cdun954/P4P-Buoy/README.md

# P4P-Buoy
University of Auckland
Department of ECSE

Project 108: Mobile Autonomous Buoy
