cdun954/P4P-Buoy/Hardware/Altium/Peripheral_PCB.PcbDoc.htm

Reporting Options

# File in Newer Format

Date | : | 12/09/2025
Time | : | 9:41:13 AM
Filename | : | Z:\Documents\GitHub\P4P-Buoy\Hardware\Altium\Peripheral_PCB.PcbDoc

Version | Warning
Release 23.6 | CAUTION - The PCB document contains Footprint parameters. These will be lost when opening the document in a version of Altium Designer that does not support this functionality.

This file was generated by a later version of the software
