cdun954/P4P-Buoy/Hardware/Altium/Peripheral_Board.html

Reporting Options

# File in Newer Format

Date | : | 9/09/2025
Time | : | 7:46:28 PM
Project name | : | Z:\Documents\GitHub\P4P-Buoy\Hardware\Altium\Peripheral_Board.PrjPcb
Schematic documents | : | P4P_PCB.SchDoc

Version | Warning
21.9.0 | Internal Pull Up/Down resistor in components are not supported in this version.
22.3.0 | Custom diff pair suffixes are not supported in this version.

These files were generated in a later version of Altium Designer. Be aware that some data may have been added through functionality not available in your current version and will therefore not be available to you.
