cdun954/P4P-Buoy/108_cdun954_cpil673-compendium/Mounting/MBB_Motor_Box_Bracket_Right_v1.stl

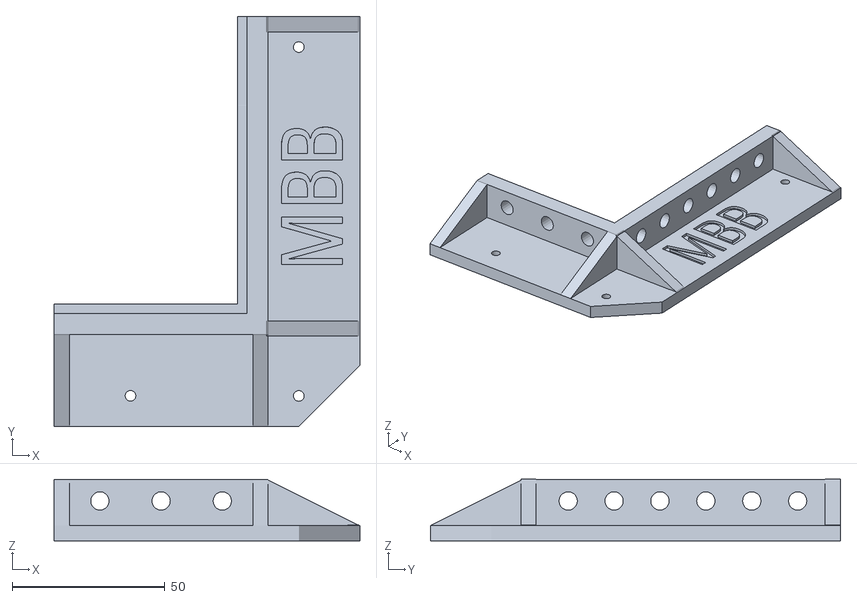
[picture p43: CAD file, 2025-10-20]
108_cdun954_cpil673-compendium/Mounting/MBB_Motor_Box_Bracket_Right_v1.stl
100.0 x 134.0 x 20.1
