cdun954/P4P-Buoy/108_cdun954_cpil673-compendium/Mounting/MBB_Box_Bracket_Front_v1.stl

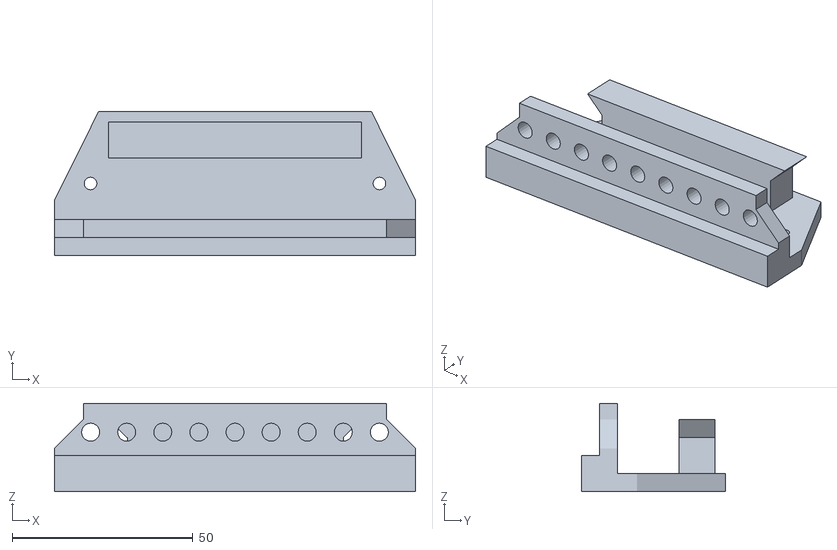
[picture p44: CAD file, 2025-10-20]
108_cdun954_cpil673-compendium/Mounting/MBB_Box_Bracket_Front_v1.stl
100.0 x 40.0 x 24.5
