cdun954/P4P-Buoy/(list of files, cad)

Other CAD files:
108_cdun954_cpil673-compendium/Mounting/MBB_Motor_Box_Bracket_Left_v2.stl
