cdun954/P4P-Buoy/108_cdun954_cpil673-compendium/setup.docx

Project 108

Compendium

Connor Dunn

Cromwell Pilacan

Supervisor: Dr Akshat Bisht

Co-supervisor: Dr Kevin I-Kai Wang

Department of Electrical, Computer and Software Engineering

The University of Auckland

October 2025

# 1 BOM

Table 1: Complete Testing BOM

Testing BOM
System | Component | Amount | Cost
Power | LiPo Batteries 5500mAh (https://hobbystation.co.nz/giant-power-4s-14-8v-5500mah-65c-graphene-hardcase-li-po-battery-w-xt60-plug/) | 2 | 358
| 5V Buck Converter (https://epartners.co.nz/products/hs1007?_pos=1&_sid=1f943ed0d&_ss=r) | 1 | 7.99
Mobility | Pixhawk6C + GPS + PM07 (https://holybro.com/products/pixhawk-6c) | 1 | 358
| T200 Motors (https://bluerobotics.com/store/thrusters/t100-t200-thrusters/t200-thruster-r2-rp/) | 2 | 800
| ESC (https://bluerobotics.com/store/thrusters/speed-controllers/besc30-r3/) | 2 | 140
Hull | Remote Controller + Receiver (https://www.aliexpress.com/item/1005005510830129.html?src=google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) | 2 | 28
| Mounting (https://bluerobotics.com/store/thrusters/t100-t200-thrusters/t100-p-bracket-r1/) | 1 | 229.93
| Boogie Board (https://www.thewarehouse.co.nz/p/body-glove-33-inches-divert-bodyboard/R2929906.html) | 1 | 35
| Water Sealant | 1 | Approximately 20
| Waterproof Box | 1 | Approximately 80
| Mounts | - | -
| Screws | 8 | -
Autonomy | Raspberry Pi 4B (https://pbtech.co.nz/product/SEVRBP0205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) | 1 | 26.08
| ESP 32 (https://www.digikey.co.nz/en/products/detail/espressif-systems/ESP32-DEVKITC-32UE/12091813?gclsrc=aw.ds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) | 1 | 17.38
| Modem (https://www.aliexpress.com/item/1005005735349781.html?src=google&gQT=2) | 1 | 75.41
| | Total Cost | 2215.79

# 2 Setup

All necessary code can be found within the zip file in their respectively named folders.

## 2.1 Flight Controller (FC)

1. Install Mission Planner (https://ardupilot.org/planner/docs/mission-planner-installation.html)
2. Connect FC via USB.
3. Flash Rover
  a. Setup → Install Firmware → Rover (OFFICIAL)
4. Connect
  a. Port: COMx (check Device Manager)
  b. Baud: 115200 → Connect
5. Load Parameters
  a. Config → Full Parameter List → Load from file → param.param → Write Params
6. Wire Peripherals
  a. PM07 Power1 → FC POWER1
  b. PM07 MAIN PWM OUT → FC I/O PWM OUT [MAIN]
  c. GPS → FC GPS1
  d. RC → FC PPM/SBUS RC
  e. Pi → FC USB
7. Calibrate
  a. Mandatory Hardware → Accelerometer (all orientations)
  b. Compass (away from interference; “Relaxed” only if needed)
  c. Radio Calibration (all channels)

## 2.2 GUI and Communication

Tailscale (https://login.tailscale.com/admin/machines)

1. Sign Up
2. Register Laptop and Pi to preset IP addresses

HiveMQ (https://console.hivemq.cloud/)

1. Sign Up
2. Create Cluster
3. Save credentials and MQTT url

Fix

1. Edit gui.py to update mqtt credentials and ips
2. Edit main.ino to update mqtt credentials and wi-fi
3. Edit main.py to update mqtt credentials

## 2.3 Raspberry Pi

1. Plug USB modem into USB
2. Flash Raspberry Pi (https://www.raspberrypi.com/software/) OS (Bookworm)
  a. Wi-Fi
  b. Set user
  c. SSH enabled
3. SSH into Pi (ssh pi@<taiscale ip>)
  a. Can check if connected via tailscale
4. Install Linux deps
  a. sudo apt update && sudo apt install -y python3-pip python3-venv tmux
5. Create Python env
  a. python3 -m venv ~/python && source ~/python/bin/activate
6. Install Python deps
  a. pip install pymavlink mavproxy paho-mqtt
7. Move project files via SSH
  a. > scp -r ./src/* pi@<ip>:/home/pi/Desktop/project
8. Move startup script and enable
  a. > scp -r ./project_boot.service pi@<ip>:/etc/systemd/system/
  b. sudo systemctl enable --now project_boot.service
  c. sudo reboot

## 2.4 ESP Power Controller

Although integration via PCB was incomplete, the ESP is setup to monitor power metrics and FSM based power switching through SSRs

1. Download IDE (https://www.arduino.cc/en/software)
  a. Flash main.ino to the ESP32

Done, just connect power, ground and things to these pins:

ADC_I_PI_PIN 36

ADC_I_FC_PIN 39

ADC_I_MODEM_PIN 34

ADC_I_ESP_PIN 35

ADC_V_BATT_PIN 32

PI_SHUTDOWN_PIN 4

RELAY_PI_PIN 23

RELAY_MODEM_PIN 22

RELAY_FC_PIN 21

## 2.5 Test Setup

Open GUI

Open Mission Planner

Power the Pi and modem

SSH into pi and run

- Tmux attach -t project

Click “MAVProxy” and it should just connect

Fake data should stream to the GUI as well.

# 3 GUI

Open gui.py

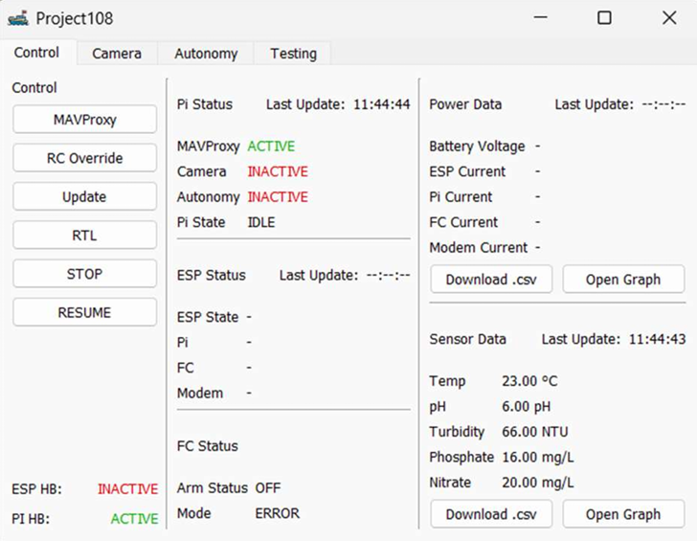
[picture p45: figure]

Control Tab

- MAVProxy : opens mavproxy through the pi
- RC Override : forces the FC into MANUAL mode
- Update : forces an update from the pi and esp
- RTL : forces the FC into RTL mode
- STOP : stops all autonomous processes and esp power control
- RESUME : resumes all autonomous processes and esp power control
- Download .csv : downloads all obtained session data
- Open Graph : Live graph of obtained session data

Camera Tab

- Toggle Camera : opens the Pi camera live feed

Autonomy Tab

- Toggle Autonomy : starts the autonomous process
- Params : alter the autonomy
- Autonomy visualiser not implemented

# 4 Lab Power Testing

The goal for lab testing was to get current readings for all peripherals intended for final design. Readings from the digital power supply was taken by visual inspection of the display over one minute, after giving enough time to boot for components running code.

### 4.1.1 Set Up

Figure below for each test ran, the components used and how they were connected. The input of the buck converter used lab available wires and alligator clips. Specific components used can be found in the testing bill of materials.

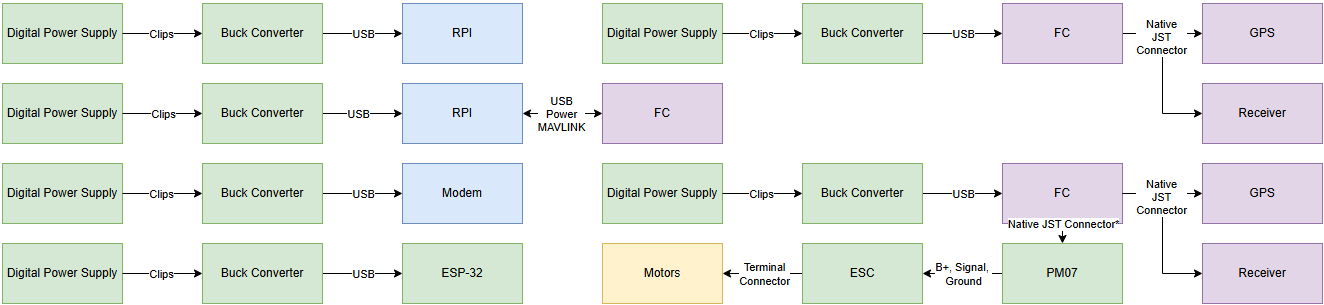
[picture p46: figure]

Figure 1.2.1: Lab Testing Connections

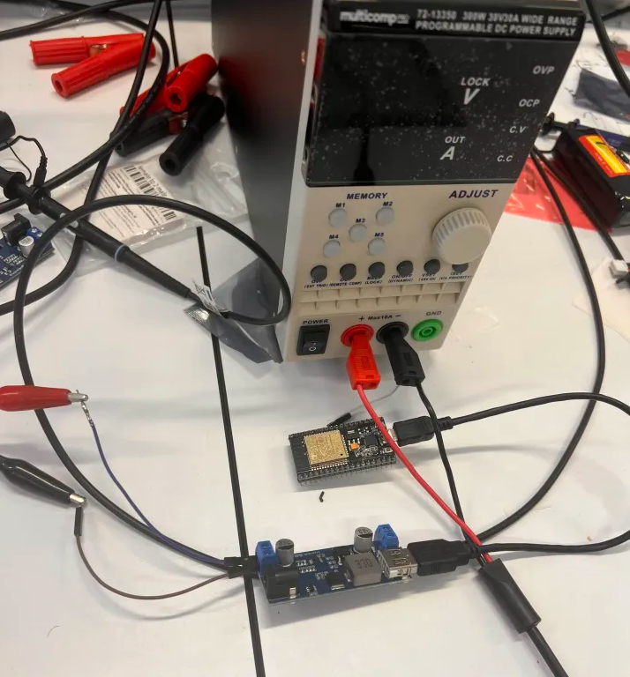
[picture p47: figure]

Figure 2.1: Photo Example of ESP Testing Set Up.

### 4.1.2 Code

The ESP ADC code and Raspberry Pi code has been included in their respective files.

### 4.1.3 Results

MAVPROXY refers to the Mavproxy process running on the Pi

ALGORITHM refers to the algorithm process running on the Pi

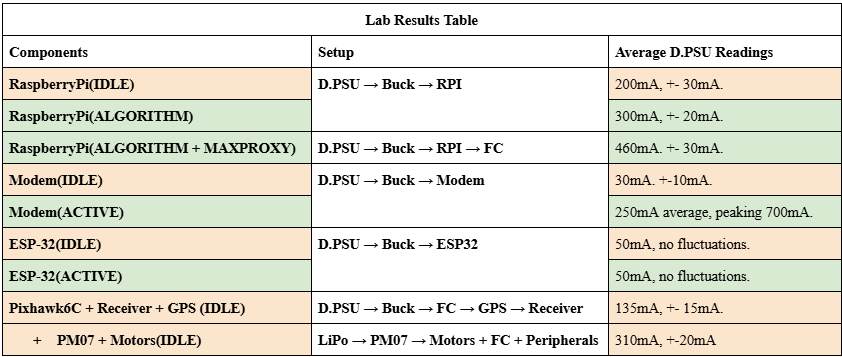
[picture p48: figure]

# 5 Field Testing

Field testing was done to get buoy speed vs current draw. Readings were taken by installing the flight logs from Mission Planner and uploaded to UAV Logger (https://plot.ardupilot.org/). This requires the BIN file. The BIN files generated from our testing is included in the Flight Controller folder.

### 5.1.1 Location

We completed all field testing at Lake Pupuke, in the separate shallow water body of water accessible by Northcote Road.

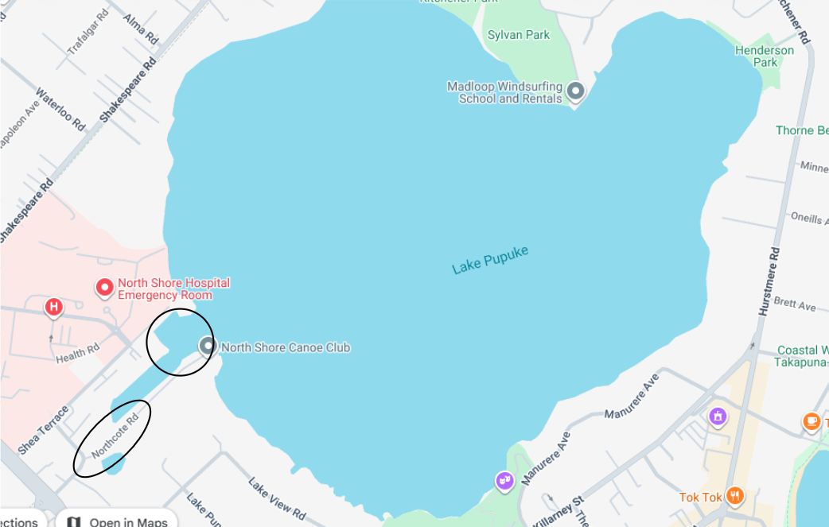
[picture p49: figure]

Figure 2.2: Location

### 5.1.2 Set Up

#### 5.1.2.1 Electronics

The power connector between the PM07 and FC was cut such that only current and voltage readings could come from the PM07, but not power.

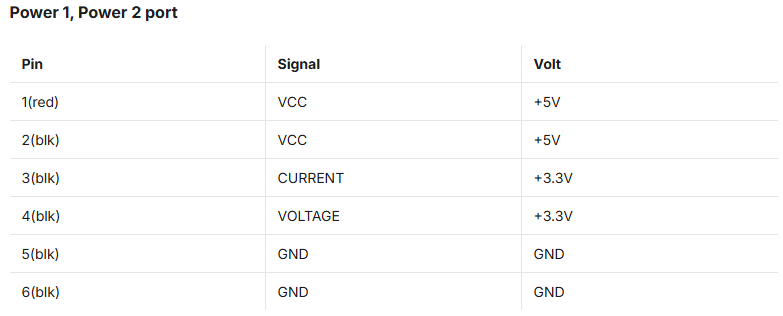
[picture p50: figure]

Figure 2.3: Power Connector Table from HolyBro (https://docs.holybro.com/power-module-and-pdb/power-module/pm07-quick-start-guide).

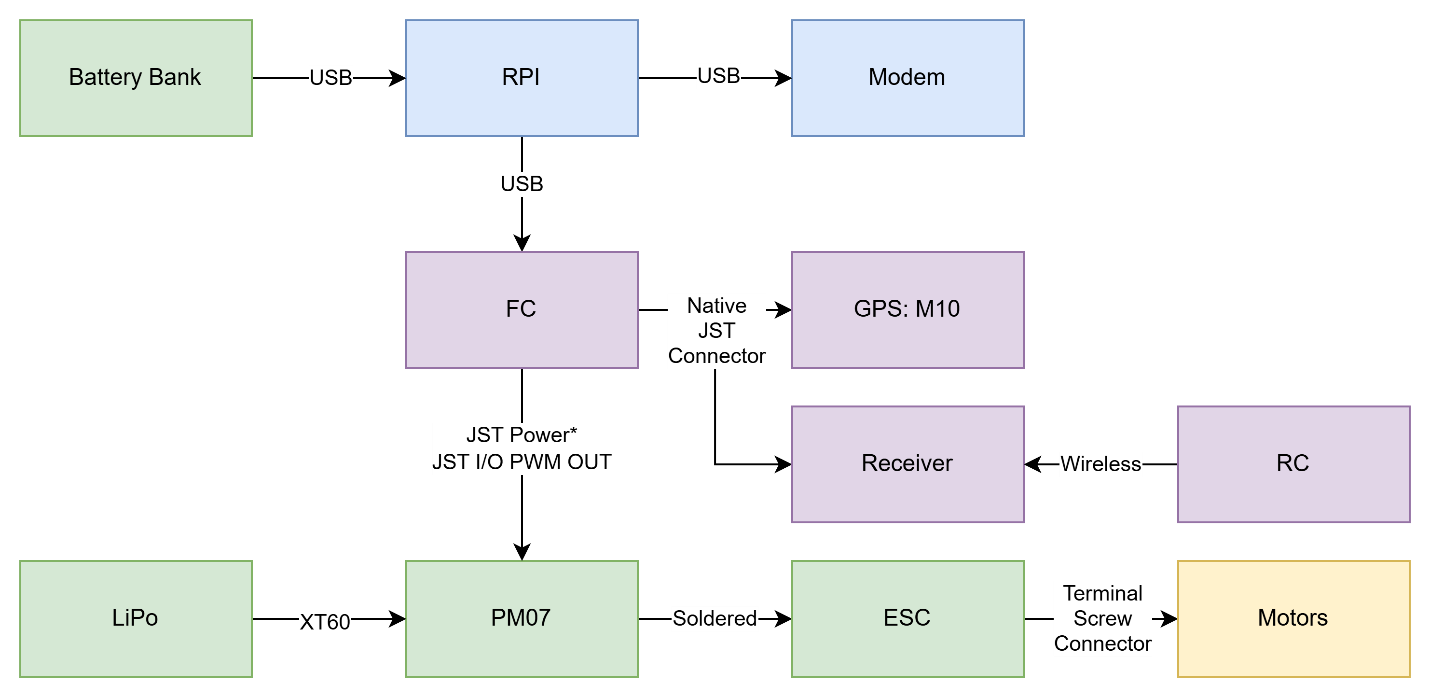
[picture p51: figure]

Figure 2.4: Electronics Connections

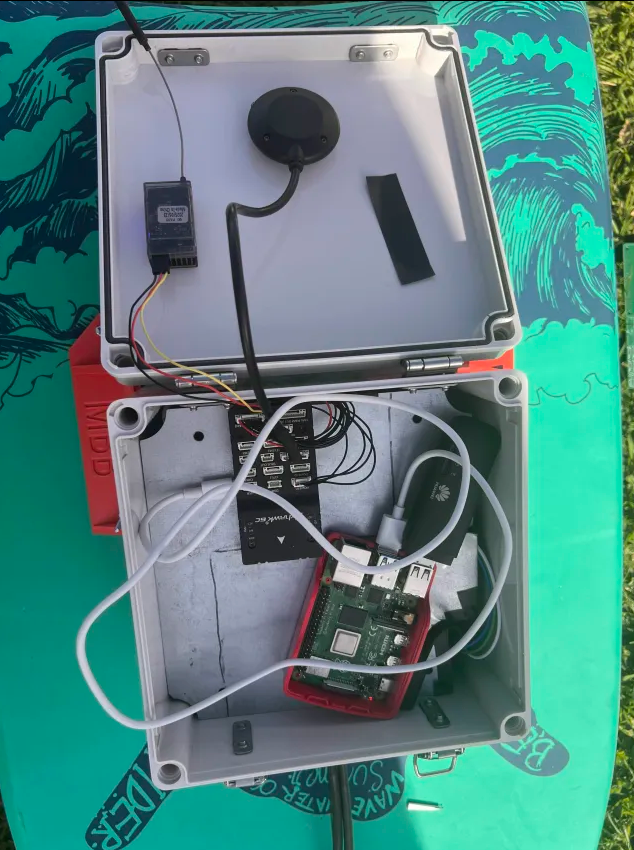
[picture p52: figure]
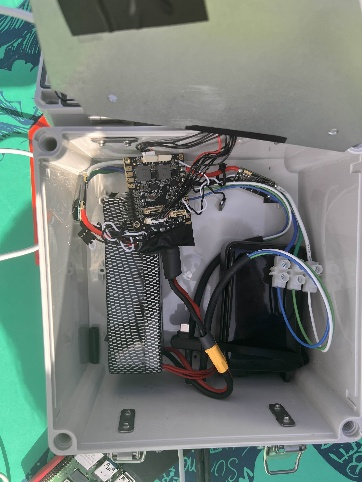
[picture p53: figure]

#### 5.1.2.2 Hull

The Figure below shows a diagram of the constructed testing hull. The files used to 3D print the mounts are included in the Mounting folder and was taken from a squirm.tech (https://squirm.tech/category/3d-printed-parts/) forum.

Figure 2.5: Diagram of Hull Set Up

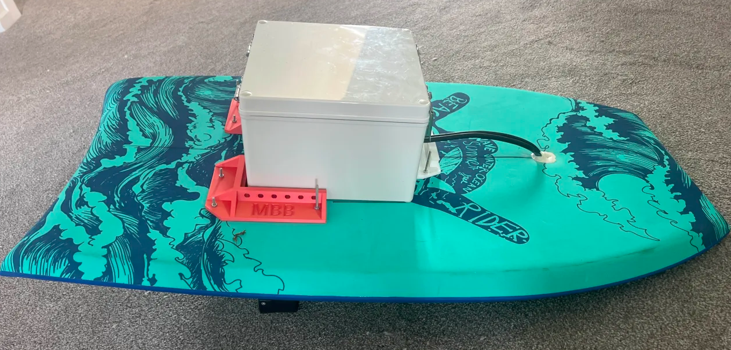
[picture p54: figure]

Figure 2.6: Photo of Testing Hull Set Up

#### 5.1.2.3 Results

Power testing results for our testing can be found in Cromwell Pilacan’s report.

# 6 SITL Simulation

Testing autonomy within mission planner involves setting up a virtual rover and sending MAVLink packets via TCP

Setup

1. Mission Planner
  a. Simulation Tab
    i. Simulation speed = 100
    ii. Press Rover

Connect

2. In the terminal that appeared, it shows the TCP port to connect to, the mav.py file within the pi controls this connection. should already be configured.
3. GUI
  a. Autonomy Tab
    i. Set parameters, low times as to not cause delays
    ii. Toggle autonomy.
4. Confirmation
  a. Terminal
    i. In the Pi TMUX it should show an autonomy window
  b. Mission Planner
    i. The Rover should go through the simulation.

Flight Logs

5. Mission Planner
  a. Data Tab
    i. Scroll across to Flight Logs
    ii. Choose an option to download or review.
