cdun954/P4P-Buoy/(list of files, drawings)

Other design files:
108_cdun954_cpil673-compendium/Hardware/PCB/P4P_PCB.SchDoc
108_cdun954_cpil673-compendium/Hardware/PCB/Peripheral_PCB.PcbDoc
Hardware/Altium/Peripheral_Board.PrjPcb
