cdun954/P4P-Buoy/108_cdun954_cpil673-compendium/Power Controller/main/main.ino

#include <WiFi.h>
#include <PubSubClient.h>
#include <WiFiClientSecure.h>
#include <HardwareSerial.h>
#include <MAVLink.h>
#include <ArduinoJson.h>
#include <esp_sleep.h>

/*
main.ino

Power management controller
Features:
- Manages power states based on battery voltage
- Handles MQTT commands from GCS
- Controls relays for power distribution
- Monitors current and voltage via ADC
- FSM with states: FULL, MID, SLEEP, CRIT
*/

/*==============================
          CONSTANTS
===============================*/ 
// ======== MAVLink ==========
#define FC_RX_PIN 16    // ESP32 RX2 (GPIO16)  <- FC TX
#define FC_TX_PIN 17    // ESP32 TX2 (GPIO17)  -> FC
#define FC_BAUD   57600

static uint8_t g_sysid  = 245;
static uint8_t g_compid = MAV_COMP_ID_ONBOARD_COMPUTER;
static uint8_t tgt_sys  = 1;
static uint8_t tgt_comp = MAV_COMP_ID_AUTOPILOT1;

// ======== PI GPIO ==========
#define PI_SHUTDOWN_PIN  4

// ======== Relays ==========
#define RELAY_PI_PIN     23
#define RELAY_MODEM_PIN  22
#define RELAY_FC_PIN     21

#define LED_BUILTIN_PIN 2  // ESP32 onboard LED

// ======= Times (ms) ==========
// some times reduced for testing
const int TIME_SLEEP  = 3600000;   // 60 min
const int TIME_TO_SLEEP = 600000;  // 10 min 
const int TIME_FC_BOOT = 5;//5000;    // 5 sec
const int TIME_MODEM_BOOT = 5;//6000; // 6 sec
const int TIME_LOAD = 5;// 2000;       // 2 sec
const int TIME_PI_SHUTDOWN = 5;//1000;// 1 sec

const int TIMER_INTERVAL = 200000; // 200 ms (us)
const int FSM_INTERVAL = 3000;   // 3 sec

// ======== ADC ==========
// if charging port is on the bottom
#define ADC_I_PI_PIN     36 // 3rd from top left
#define ADC_I_FC_PIN     39 // 4th
#define ADC_I_MODEM_PIN  34 // 5th
#define ADC_I_ESP_PIN    35 // 6th
#define ADC_V_BATT_PIN   32 // 7th

const float ADC_VREF      = 3.3;      // ESP32 ADC reference (Volts)
const int   ADC_RES       = 12;       // 12-bit ADC
const float ADC_MAX       = 4095;     // 12-bit ADC
const float ADC_I_ADD     = 0.05;       // current sensor addition factor?
const float ADC_V_CONV    = 5.1*4;       // voltage battery conversion factor

// ======== Voltage Thresholds ==========
const float V_HYSTERESIS    = 0.7;
const float V_MID_BOUNDARY  = 14.4; 
const float V_SLEEP_BOUNDARY  = 13.8;
const float V_CRIT_BOUNDARY = 13.5;   
const float V_ABSOLUTE_MIN  = 12.0;   // below this, shut everything down

// ======== WiFi ==========
const char* WIFI_SSID = "IE_Room_BKUP";
const char* WIFI_PW   = "ieroom12345";

// ======== MQTT ==========
const char* MQTT_HOST = "f1bd5a3c43044a3a816321410ca2043.s1.eu.hivemq.cloud";
const int   MQTT_PORT = 8883;
const char* MQTT_USER = "P4P-Buoy";  
const char* MQTT_PASS = "P4P108-buoy"; 

static const char CA_CERT[] PROGMEM = R"EOF(
-----BEGIN CERTIFICATE-----
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
-----END CERTIFICATE-----
)EOF";

const char* MQTT_TOPIC_CMD    = "buoy/esp/cmd";
const char* MQTT_TOPIC_STATUS = "buoy/esp/status";
const char* MQTT_TOPIC_POWER  = "buoy/esp/power";
const char* MQTT_TOPIC_PANIC  = "buoy/esp/panic";

/*==============================
            GLOBALS
===============================*/
// WiFi and MQTT clients
WiFiClientSecure wifiClient;
PubSubClient client(wifiClient);
String clientId;

// MAVLink
HardwareSerial FC(2);
static mavlink_message_t rx_msg;
static mavlink_status_t  rx_status;

// Relay status'
bool relayPiStatus    = false;
bool relayModemStatus = false;
bool relayFCStatus    = false;

// State
enum State { IDLE, FULL, MID, SLEEP, CRIT };
State state = FULL;
State prevState = FULL;

// Timing
unsigned long time_till_sleep = 0;

// HW Timer
hw_timer_t * timer = nullptr;
portMUX_TYPE timerMux = portMUX_INITIALIZER_UNLOCKED;
volatile bool timerFlag = false;

static unsigned long lastComms = 0;


// ADC
float adc_v_batt = 16.8; // max
float adc_i_pi   = 0.0;
float adc_i_fc   = 0.0;
float adc_i_modem= 0.0;
float adc_i_esp  = 0.0;

/*==============================
      FORWARD DECLARATIONS
===============================*/
// MQTT/WiFi
void setupWiFi();
void wifiEnsureConnected();
void setupMQTT();
void mqttEnsureConnected();
void mqttCallback(char* topic, byte* payload, unsigned int len);
bool sendMsg(const char* topic, const char* msg);
void tickComms();

// MQTT commands
void cmdUpdate();
void updateStatus();
void updatePower();
void cmdPause();
void cmdResume();
void cmdForceRTL();

// FSM
void enterState(State s);
void doEnterFull();
void doEnterMid();
void doEnterSleep();
void doEnterCrit();
void doEnterIdle();
const char* getStateName(State s);

// ADC
float readBattVoltage();
float readADCCurrent(int pin);

// Timer
void IRAM_ATTR onTimer();
void setupTimer();
void timerStop();
void timerStart();

// Relays / Pins
void setupPins();
void relayModemOn();
void relayModemOff();
void relayPiOn();
void relayPiOff();
void relayFCOn();
void relayFCOff();

// FC / MAVLink
void mavArmFC();
void mavDisarmFC();
void mavForceRTL();
float* getFCGPS();
static void mav_send(const mavlink_message_t &m);
static void mav_cmd_long(uint16_t command,
                         float p1=0,float p2=0,float p3=0,float p4=0,
                         float p5=0,float p6=0,float p7=0);


/*==============================
          HW TIMER
===============================*/
void IRAM_ATTR onTimer() {
    portENTER_CRITICAL(&timerMux);
    timerFlag = true;
    portEXIT_CRITICAL(&timerMux);
}

void setupTimer() {
  // timer 1 MHz
  timer = timerBegin(1000000);                 // frequency in Hz
  timerAttachInterrupt(timer, &onTimer); 
  // Alarm after 1,000,000 us = 1 s, auto-reload forever (0 = unlimited)
  timerAlarm(timer, TIMER_INTERVAL, true, 0);
  //Serial.println("[SETUP] Timer Setup!");
}

void timerStart(){
  timerStart(timer); 
  //Serial.println("[TIMER] Started...");
}

void timerStop(){
  timerStop(timer);
  //Serial.println("[TIMER] Stopped!");
}

/*==============================
          MQTT COMMANDS
===============================*/
void cmdUpdate() {
  updateStatus();
  updatePower();
}

void updateStatus() {
  const char* stateName = getStateName(state);
  bool relay_pi         = relayPiStatus;
  bool relay_modem      = relayModemStatus;
  bool relay_fc         = relayFCStatus;

  StaticJsonDocument<256> statusDoc;
  statusDoc["state"]      = stateName;
  statusDoc["relay_pi"]   = relay_pi;
  statusDoc["relay_modem"]= relay_modem;
  statusDoc["relay_fc"]   = relay_fc; 

  char statusBuf[192];
  size_t sn = serializeJson(statusDoc, statusBuf, sizeof(statusBuf));
  if (sn == 0 || sn >= sizeof(statusBuf)) {
    //Serial.println("[MQTT] STATUS //Serialize failed");
  } else if (!client.publish(MQTT_TOPIC_STATUS, statusBuf)) {
    //Serial.println("[MQTT] STATUS publish failed");
  } else {
    //Serial.println("[MQTT] STATUS sent");
  }
}

void updatePower() {
  float v_batt          = adc_v_batt;
  float i_pi            = adc_i_pi;
  float i_fc            = adc_i_fc;
  float i_modem         = adc_i_modem;
  float i_esp           = adc_i_esp;

  StaticJsonDocument<256> powerDoc;
  powerDoc["v_batt"]     = v_batt;
  powerDoc["i_pi"]       = i_pi;
  powerDoc["i_fc"]       = i_fc;
  powerDoc["i_modem"]    = i_modem;
  powerDoc["i_esp"]      = i_esp;

  char powerBuf[256];
  size_t pn = serializeJson(powerDoc, powerBuf, sizeof(powerBuf));
  if (pn == 0 || pn >= sizeof(powerBuf)) {
    //Serial.println("[MQTT] POWER //Serialize failed");
  } else if (!client.publish(MQTT_TOPIC_POWER, powerBuf)) {
    //Serial.println("[MQTT] POWER publish failed");
  } else {
    //Serial.println("[MQTT] POWER sent");
  }
}

void cmdPause() {
  // pause all operations
  // enter idle state
  if (state != IDLE) prevState = state;
  enterState(IDLE);
}

void cmdResume() {
  // resume operations
  enterState(prevState);
}

void cmdForceRTL() {
  // CRIT is designed to force RTL
  // enter CRIT state
  enterState(CRIT); // V_SLEEP_BOUNDARY
}

struct Cmd {
  const char* name;
  void (*func)();
};

Cmd commands[] = {
  {"update", cmdUpdate},
  {"pause", cmdPause},
  {"resume", cmdResume},
  {"rtl", cmdForceRTL}
};  

/*==============================
      MQTT/WIFI FUNCTIONS
===============================*/
void setupWiFi() {
  WiFi.mode(WIFI_STA);
  //Serial.println("[SETUP] Wifi Configured!");
}

void wifiEnsureConnected(){
  if (WiFi.status() == WL_CONNECTED) return;
  WiFi.begin(WIFI_SSID, WIFI_PW);
  //Serial.println("[WiFi] Connecting...");
  while (WiFi.status() != WL_CONNECTED) { delay(300); }
  //Serial.println("[WiFi] Connected!");
}

void setupMQTT() {
  wifiClient.setCACert(CA_CERT);
  client.setServer(MQTT_HOST, MQTT_PORT);
  client.setCallback(mqttCallback);
  clientId = "esp32-" + String((uint32_t)ESP.getEfuseMac(), HEX);
  //Serial.println("[SETUP] MQTT Configured!");
}

void mqttEnsureConnected() {
  if (client.connected()) return;
  //Serial.println("[MQTT] Connecting...");
  while (!client.connected()) {
    if (client.connect(clientId.c_str(), MQTT_USER, MQTT_PASS)) {
      client.subscribe(MQTT_TOPIC_CMD);
    } else { delay(300); }
  }
  //Serial.println("[MQTT] Connected");
}

void mqttCallback(char* topic, byte* payload, unsigned int len) {
  static char msg[512];
  len = min(len, (unsigned int)(sizeof(msg)-1));
  memcpy(msg, payload, len);
  msg[len] = '\0';
  //Serial.printf("[MQTT] Msg received on topic: %s\n", topic);
  if (strcmp(topic, MQTT_TOPIC_CMD) == 0) {
    for (auto &cmd : commands) {
      if (strcmp(msg, cmd.name) == 0) {
        cmd.func();
        return;
      }
    }
  }
}


/*==============================
          ADC FUNCTIONS
===============================*/
float readBattVoltage(){
  int raw = analogReadMilliVolts(ADC_V_BATT_PIN);
  float v = raw * ADC_V_CONV;   // Convert to real battery voltage
  //Serial.print("[ADC] Read!");
  //Serial.println(v);
  return v;
}

float readADCCurrent(int pin){
  return (analogReadMilliVolts(pin) -142.0) / 1000.0;
}

/*==============================
          RELAY FUNCTIONS
===============================*/

// need to ensure they are held in case of sleep power mode (ie deep sleep)
void setupPins(){
  pinMode(RELAY_PI_PIN, OUTPUT);
  pinMode(RELAY_MODEM_PIN, OUTPUT);
  pinMode(RELAY_FC_PIN, OUTPUT);
  pinMode(PI_SHUTDOWN_PIN, OUTPUT);
  pinMode(LED_BUILTIN_PIN, OUTPUT);

  // set all to low
  digitalWrite(RELAY_PI_PIN, LOW);
  digitalWrite(RELAY_MODEM_PIN, LOW);
  digitalWrite(RELAY_FC_PIN, LOW);
  digitalWrite(PI_SHUTDOWN_PIN, LOW);
  relayFCStatus    = false;
  relayPiStatus    = false;
  relayModemStatus = false;

  // turn ON builtin led
  digitalWrite(LED_BUILTIN_PIN, HIGH);

  //Serial.println("[SETUP] Pins Setup!");
}


void relayModemOn(){
  if (!relayModemStatus){
    digitalWrite(RELAY_MODEM_PIN, HIGH);
    relayModemStatus = true;
    //Serial.println("[RELAY] Modem Switched On");
    delay(TIME_MODEM_BOOT);
    wifiEnsureConnected();
    mqttEnsureConnected();
  }
}

void relayModemOff(){
  if (relayModemStatus){
    digitalWrite(RELAY_MODEM_PIN, LOW);
    relayModemStatus = false;
    //Serial.println("[RELAY] Modem Switched Off");
  }
}

void relayPiOn(){
  if (!relayPiStatus){
    digitalWrite(RELAY_PI_PIN, HIGH);
    relayPiStatus = true;
    //Serial.println("[RELAY] Pi Switched On");
  }
}

void relayPiOff(){
  if (relayPiStatus){
    digitalWrite(PI_SHUTDOWN_PIN, HIGH);
    delay(TIME_PI_SHUTDOWN);
    digitalWrite(RELAY_PI_PIN, LOW);
    relayPiStatus = false;
    //Serial.println("[RELAY] Pi Switched Off");
  }
  
}

void relayFCOn(){
  if (!relayFCStatus){
    digitalWrite(RELAY_FC_PIN, HIGH);
    relayFCStatus = true;
    // wait for boot
    delay(TIME_FC_BOOT);
    //Serial.println("[RELAY] FC Switched On");
  }
}

void relayFCOff(){
  // disarm first, then wait
  if (relayFCStatus){
    mavDisarmFC();
    digitalWrite(RELAY_FC_PIN, LOW);
    relayFCStatus = false;
    //Serial.println("[RELAY] FC Switched Off");
  }
}

/*==============================
      FC/MAVLink FUNCTIONS
===============================*/
void mavArmFC() {
  mav_cmd_long(MAV_CMD_COMPONENT_ARM_DISARM, 1.0f);
  delay(TIME_LOAD);
  //Serial.println(F("[MAV] ARM sent"));
}

void mavDisarmFC() {
  mav_cmd_long(MAV_CMD_COMPONENT_ARM_DISARM, 0.0f);
  delay(TIME_LOAD);
  //Serial.println(F("[MAV] DISARM sent"));
}

void mavForceRTL() {
  mavlink_message_t m;
  const uint8_t  base_mode   = MAV_MODE_FLAG_CUSTOM_MODE_ENABLED;
  const uint32_t custom_mode = 8; // Rover Smart RTL 
  mavlink_msg_set_mode_pack(g_sysid, g_compid, &m, tgt_sys, base_mode, custom_mode);
  mav_send(m);
  //Serial.println(F("[MAV] RTL sent"));
}

float* getFCGPS() {
  static float res[4] = {NAN, NAN, NAN, NAN};  // {lat, lon, alt, hdg}

  while (FC.available()) {
    const uint8_t c = FC.read();
    if (mavlink_parse_char(MAVLINK_COMM_0, c, &rx_msg, &rx_status)) {
      switch (rx_msg.msgid) {

        case MAVLINK_MSG_ID_GLOBAL_POSITION_INT: {
          mavlink_global_position_int_t g;
          mavlink_msg_global_position_int_decode(&rx_msg, &g);
          res[0] = g.lat / 1e7;
          res[1] = g.lon / 1e7;
          res[2] = g.alt / 1000.0f;                            // m AMSL
          res[3] = (g.hdg == UINT16_MAX) ? NAN : (g.hdg / 100.0f);
          return res;
        }

        case MAVLINK_MSG_ID_GPS_RAW_INT: {
          mavlink_gps_raw_int_t r;
          mavlink_msg_gps_raw_int_decode(&rx_msg, &r);
          if (r.fix_type >= 2) {
            res[0] = r.lat / 1e7;
            res[1] = r.lon / 1e7;
            res[2] = r.alt / 1000.0f;
            res[3] = NAN; // heading not provided
            return res;
          }
        } break;

        default:
          break;
      }
    }
  }
  return res; // unchanged {NAN,NAN,NAN,NAN} if nothing seen
}
  
static void mav_send(const mavlink_message_t &m) {
  uint8_t buf[MAVLINK_MAX_PACKET_LEN];
  const uint16_t n = mavlink_msg_to_send_buffer(buf, &m);
  FC.write(buf, n);
}

static void mav_cmd_long(uint16_t command,
                         float p1,float p2,float p3,float p4,
                         float p5,float p6,float p7) {
  mavlink_message_t m;
  mavlink_msg_command_long_pack(
    g_sysid, g_compid, &m,
    tgt_sys, tgt_comp, command, 0,
    p1,p2,p3,p4,p5,p6,p7);
  mav_send(m);
}


/*==============================
          FSM FUNCTIONS
===============================*/
const char* getStateName(State s) {
  switch (s) {
    case IDLE:  return "IDLE";
    case FULL:  return "FULL";
    case MID:   return "MID";
    case SLEEP: return "SLEEP";
    case CRIT:  return "CRIT";
    default:    return "UNKNOWN";
  }
}

void enterState(State s) {
  state = s;
  //Serial.printf("[FSM] Entering State: %s\n", getStateName(s));
  switch (state){
    case FULL: doEnterFull(); break;
    case MID: doEnterMid(); break;
    case SLEEP: doEnterSleep(); break;
    case CRIT: doEnterCrit(); break;
    case IDLE: doEnterIdle(); break;
  }
}

void doEnterFull(){
  // ensure all systems on
  timerStart();
  relayPiOn();
  relayFCOn();
  relayModemOn();
}

void doEnterMid(){
  // ensure all on except for FC
  // must disarm and force fc shutdown first
  timerStart();
  relayPiOn();
  relayModemOn();
  relayFCOff();
}

void doEnterSleep(){
  // everything is off
  // deep sleep for period of time
  timerStop();
  relayPiOff();
  relayModemOn();
  relayFCOff();
  time_till_sleep = millis();
}

void doEnterCrit(){
  // ensure all off
  // force RTL
  timerStop();
  relayPiOff();
  relayModemOff();
  relayFCOn();
  mavArmFC();
  mavForceRTL();
}

void doEnterIdle(){
  timerStart();
  relayModemOn();
  relayPiOn();
  relayFCOff();
}

void tickComms(){
  // only every x seconds
  if (millis() - lastComms < FSM_INTERVAL) return;
  lastComms = millis();
  wifiEnsureConnected();
  mqttEnsureConnected();
  client.loop();
  updateStatus();
}


/*==============================
            SETUP
===============================*/
void setup() {
  //Serial.begin(115200);
  setCpuFrequencyMhz(80);

  // init adc
  analogReadResolution(ADC_RES); // 12-bit
  analogSetAttenuation(ADC_11db); // Full-scale ~3.3–3.6 V

  // determine state from battery voltage
  State s = IDLE; // default
  //float v_batt = readBattVoltage();
  float v_batt = 16.8; // assume full for initial testing
  if (v_batt >= V_MID_BOUNDARY) s = FULL;
  else if (v_batt >= V_SLEEP_BOUNDARY) s = MID;
  else if (v_batt >= V_CRIT_BOUNDARY) s = SLEEP;
  else s = CRIT;

  // init rest of system
  FC.begin(FC_BAUD, SERIAL_8N1, FC_RX_PIN, FC_TX_PIN);
  setupPins();
  setupTimer();
  
  setupWiFi();
  setupMQTT();

  enterState(s);
}

/*==============================
            LOOP
===============================*/
void loop() {
  
  bool do_sample = false;
  portENTER_CRITICAL(&timerMux);
  if (timerFlag) { 
    timerFlag = false;
    do_sample = true;
  }
  portEXIT_CRITICAL(&timerMux);
  if (do_sample) {
    //adc_v_batt = readBattVoltage();
    adc_i_pi   = readADCCurrent(ADC_I_PI_PIN);
    adc_i_fc   = readADCCurrent(ADC_I_FC_PIN);
    adc_i_modem= readADCCurrent(ADC_I_MODEM_PIN);
    adc_i_esp  = readADCCurrent(ADC_I_ESP_PIN);

    updatePower();
  }

  switch (state) {
    case FULL:
      tickComms();
      if (adc_v_batt < V_MID_BOUNDARY) enterState(MID);
      break;

    case MID:
      tickComms();
      if (adc_v_batt >= V_MID_BOUNDARY + V_HYSTERESIS) enterState(FULL);
      if (adc_v_batt < V_SLEEP_BOUNDARY) enterState(SLEEP);
      break;

    case SLEEP:
      if (adc_v_batt >= V_SLEEP_BOUNDARY + V_HYSTERESIS) enterState(MID);
      if (adc_v_batt < V_CRIT_BOUNDARY) enterState(CRIT);
      // deep sleep after being in sleep state for x min
      if (millis() - time_till_sleep >= TIME_TO_SLEEP) {
        relayModemOff();
        esp_sleep_enable_timer_wakeup(TIME_SLEEP * 1000ULL);
        esp_deep_sleep_start();
      }
      break;
    
    case CRIT:
      if (adc_v_batt <= V_ABSOLUTE_MIN) {
          mavDisarmFC();
          relayFCOff();
          relayModemOn();
          wifiEnsureConnected();
          mqttEnsureConnected();
          client.publish(MQTT_TOPIC_PANIC, "HELP!");
          // deep sleep
          esp_sleep_enable_timer_wakeup(TIME_SLEEP * 1000ULL);
          esp_deep_sleep_start();
        }
      break;

    case IDLE:
      tickComms();
      break;
  }
  delay(50);
}
