cdun954/P4P-Buoy/Firmware/Power_ESP32/test_sketch/test_sketch.ino

#include <WiFi.h>
#include <PubSubClient.h>
#include <WiFiClientSecure.h>

/*==============================
          CONSTANTS
===============================*/ 

// ======== Relays ==========
#define RELAY_PI_PIN     23
#define RELAY_MODEM_PIN  22
#define RELAY_FC_PIN     21

// ======== ADC ==========
#define ADC_I_PI_PIN     36
#define ADC_I_FC_PIN     39
#define ADC_I_MODEM_PIN  34
#define ADC_I_ESP_PIN    35
#define ADC_V_BATT_PIN   32

const float ADC_VREF      = 3.3;      // ESP32 ADC reference (Volts)
const int   ADC_RES       = 12;       // 12-bit ADC
const float ADC_MAX       = 4095;     // 12-bit ADC
const float ADC_I_CONV    = 69;       // current sensor conversion factor
const float ADC_V_CONV    = 69;       // voltage battery conversion factor

// ======== Voltage Thresholds ==========
const float V_HYSTERESIS    = 0.3;
const float V_MID_BOUNDARY  = 14.8;
const float V_LOW_BOUNDARY  = 14;
const float V_CRIT_BOUNDARY = 13.2;

// ======== WiFi ==========
const char* WIFI_SSID = "IE_Room_BKUP";
const char* WIFI_PW   = "ieroom12345";

// ======== MQTT ==========
const char* MQTT_HOST = "f1bd5a3c43044a3a816321410ca20435.s1.eu.hivemq.cloud";
const int   MQTT_PORT = 8883;
const char* MQTT_USER = "P4P-Buoy";  
const char* MQTT_PASS = "P4P108buoy"; 

static const char CA_CERT[] PROGMEM = R"EOF(
-----BEGIN CERTIFICATE-----
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
-----END CERTIFICATE-----
)EOF";

const char* MQTT_TOPIC_SUB = "esp/cmd";
const char* MQTT_TOPIC_PUB = "esp/telem";

/*==============================
            GLOBALS
===============================*/
enum State {
  FULL,
  MID,
  LOW,
  CRIT
};
State state;

WiFiClientSecure wifiClient;
PubSubClient client(wifiClient);
String clientId;

/*==============================
      MQTT/WIFI FUNCTIONS
===============================*/
void setupWiFi() {
  WiFi.mode(WIFI_STA);
  WiFi.begin(WIFI_SSID, WIFI_PW);
  while (WiFi.status() != WL_CONNECTED) { delay(300); }
}

void setupMQTT() {
  wifiClient.setCACert(CA_CERT);
  client.setServer(MQTT_HOST, MQTT_PORT);
  client.setCallback(mqttCallback);
  clientId = "esp32-" + String((uint32_t)ESP.getEfuseMac(), HEX);
}

void mqttEnsureConnected() {
  while (!client.connected()) {
    if (client.connect(clientId.c_str(), MQTT_USER, MQTT_PASS)) {
      client.subscribe(MQTT_TOPIC_SUB);
    } else { delay(2000); }
  }
}

void mqttCallback(char* topic, byte* payload, unsigned int len) {
  static char msg[512];
  len = min(len, (unsigned int)(sizeof(msg)-1));
  memcpy(msg, payload, len);
  msg[len] = '\0';
  handleMsg(topic, msg);
}

void handleMsg(const char* topic, const char* msg) {
  if (strcmp(topic, MQTT_TOPIC_SUB) == 0) {
    // example command handle
    if (strcmp(msg, "update_status") == 0) {
      sendMsg(MQTT_TOPIC_PUB, "status:OK");
    }
    // add more here
  }
}

bool sendMsg(const char* topic, const char* msg) {
  return client.publish(topic, msg);
}


/*==============================
          ADC FUNCTIONS
===============================*/
float readBattVoltage(){
  int raw = analogRead(ADC_V_BATT_PIN);
  float v_adc  = (raw / ADC_MAX) * ADC_VREF; // convert to pin voltage
  float v = v_adc * ADC_V_CONV;   // Convert to real battery voltage
  return v;
}

float readADCCurrent(int pin){
  int raw = analogRead(pin);
  float v_adc  = (raw / ADC_MAX) * ADC_VREF; // convert to pin voltage
  float cur = v_adc * ADC_I_CONV;   // Convert to real current 
  return cur;
}

/*==============================
          FSM FUNCTIONS
===============================*/
void enterState(State s) {
  state = s;
  switch (state){
    case FULL:
      // entering full
      // ensure all systems on
      break;

    case MID:
      // entering mid
      // ensure all on except for FC
      // must disarm and force fc shutdown first
      break;

    case LOW:
      // entering low
      // ensure all off 
      // need to let pi know to shutdown
      break;

    case CRIT:
      // entering crit
      // ensure all off
      // turn FC on
      // arm FC
      // force RTL
      break;
  }
}

void doFull(){
  // full behaviour here
  // pretty much just monitor and report
}

void doMid(){
  // mid behaviour here
  // pretty much just monitor and report
}

void doLow(){
  // low behaviour here
  // deep sleep for period of time
  // wake up, check voltage and report
  // go back to sleep
}



/*==============================
            SETUP
===============================*/
void setup() {
  // init adc
  analogReadResolution(ADC_RES); // 12-bit
  analogSetAttenuation(ADC_11db); // Full-scale ~3.3–3.6 V
  
  // init rest of system
  Serial.begin(115200);
  setupWiFi();
  setupMQTT();

  // determine state from battery voltage
  float v_batt = readBattVoltage();
  if (v_batt >= V_MID_BOUNDARY) enterState(FULL);
  else if (v_batt >= V_LOW_BOUNDARY) enterState(MID);
  else if (v_batt >= V_CRIT_BOUNDARY) enterState(LOW);
  else enterState(CRIT);
}

/*==============================
            LOOP
===============================*/
void loop() {
  float v_batt = readBattVoltage();

  switch (state) {
    case FULL:
      doFull();
      if (v_batt < V_MID_BOUNDARY) enterState(MID);
      break;

    case MID:
      doMid();
      if (v_batt >= V_MID_BOUNDARY + V_HYSTERESIS) enterState(FULL);
      if (v_batt < V_LOW_BOUNDARY) enterState(LOW);
      break;

    case LOW:
      doLow();
      if (v_batt >= V_LOW_BOUNDARY + V_HYSTERESIS) enterState(MID);
      if (v_batt < V_CRIT_BOUNDARY) enterState(CRIT);
      break;
  }
}
