cdun954/P4P-Buoy/108_cdun954_cpil673-compendium/Power Controller/mqtt_test/mqtt_test.ino

#include <WiFi.h>
#include <PubSubClient.h>
#include <WiFiClientSecure.h>

// WiFi credentials
const char* ssid = "IE_Room_BKUP";
const char* password = "ieroom12345";

// HiveMQ Cloud details
const char* mqtt_server = "f1bd5a3c43044a3a816321410ca20435.s1.eu.hivemq.cloud";
const int mqtt_port = 8883;
const char* mqtt_user = "P4P-Buoy";  
const char* mqtt_pass = "P4P108buoy";  

// Root CA cert
static const char ca_cert[] PROGMEM = R"EOF(
-----BEGIN CERTIFICATE-----
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
-----END CERTIFICATE-----
)EOF";

WiFiClientSecure wifiClient;
PubSubClient client(wifiClient);

void callback(char* topic, byte* payload, unsigned int length) {
  Serial.print("Message arrived [");
  Serial.print(topic);
  Serial.print("] ");
  for (unsigned int i = 0; i < length; i++) {
    Serial.print((char)payload[i]);
  }
  Serial.println();
}

void reconnect() {
  while (!client.connected()) {
    Serial.print("Attempting MQTT connection... ");
    if (client.connect("esp32client", mqtt_user, mqtt_pass)) {
      Serial.println("connected!");
      client.subscribe("esp/cmd");
    } else {
      Serial.print("failed, rc=");
      Serial.print(client.state());
      Serial.println(" try again in 5 sec");
      delay(5000);
    }
  }
}

void setup() {
  Serial.begin(115200);
  WiFi.begin(ssid, password);

  Serial.print("Connecting to WiFi");
  while (WiFi.status() != WL_CONNECTED) {
    delay(500);
    Serial.print(".");
  }
  Serial.println("\nWiFi connected!");

  wifiClient.setCACert(ca_cert);
  client.setServer(mqtt_server, mqtt_port);
  client.setCallback(callback);
}

void loop() {
  if (!client.connected()) {
    reconnect();
  }
  client.loop();

  static unsigned long lastSend = 0;
  if (millis() - lastSend > 2000) {
    lastSend = millis();
    char msg[50];
    int value = random(0, 100);
    sprintf(msg, "value:%d", value);
    Serial.print("Publishing: ");
    Serial.println(msg);
    client.publish("esp/test", msg);
  }
}
