cdun954/P4P-Buoy/(commit log)

2025-09-02 Initial ESP32 Code
2025-09-04 ADC setup
2025-09-05 Added altium files
    [P4P_PCB.SchDoc, Peripheral_Board.PrjPcb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]
2025-09-05 Updated project file
    [P4P_PCB.SchDoc]
2025-09-05 Updated project file
    Added schematic file to project
    [P4P_PCB.SchDoc, Peripheral_Board.PrjPcb]
2025-09-05 Sonar script
2025-09-07 Updated project files
    i actually do not know why it always does this
    [Peripheral_Board.PrjPcb, Peripheral_PCB.PcbDoc]
2025-09-08 GUI Camera + MAVProxy
2025-09-09 Versiuon 1.1 PCB
    [P4P_PCB.SchDoc, Peripheral_PCB.PcbDoc]
2025-09-09 4g and fc implementation left
    [P4P_PCB.SchDoc, Peripheral_PCB.PcbDoc]
2025-09-10 Version 1.1 completed
    [P4P_PCB.SchDoc, Peripheral_PCB.PcbDoc]
2025-09-10 symbols and divider
    added +- symbols to headers and added divider for arduino to fc communications
    [P4P_PCB.SchDoc, Peripheral_PCB.PcbDoc]
2025-09-11 updated by meeting requirements
    [P4P_PCB.SchDoc, Peripheral_PCB.PcbDoc]
2025-09-11 fix
    added +- to motor inputs
    [Peripheral_PCB.PcbDoc]
2025-09-11 no changes
    [Peripheral_PCB.PcbDoc]
2025-09-11 updated errors
    [Peripheral_PCB.PcbDoc]
2025-09-14 added keepout lines
    [Peripheral_PCB.PcbDoc]
